MaximilianoMontenegro/TD2/C_FreeRTOS_Digital_ECG_Monitor_DSP/docs/analisis_python/figuras/sesion_ECG_0003.png

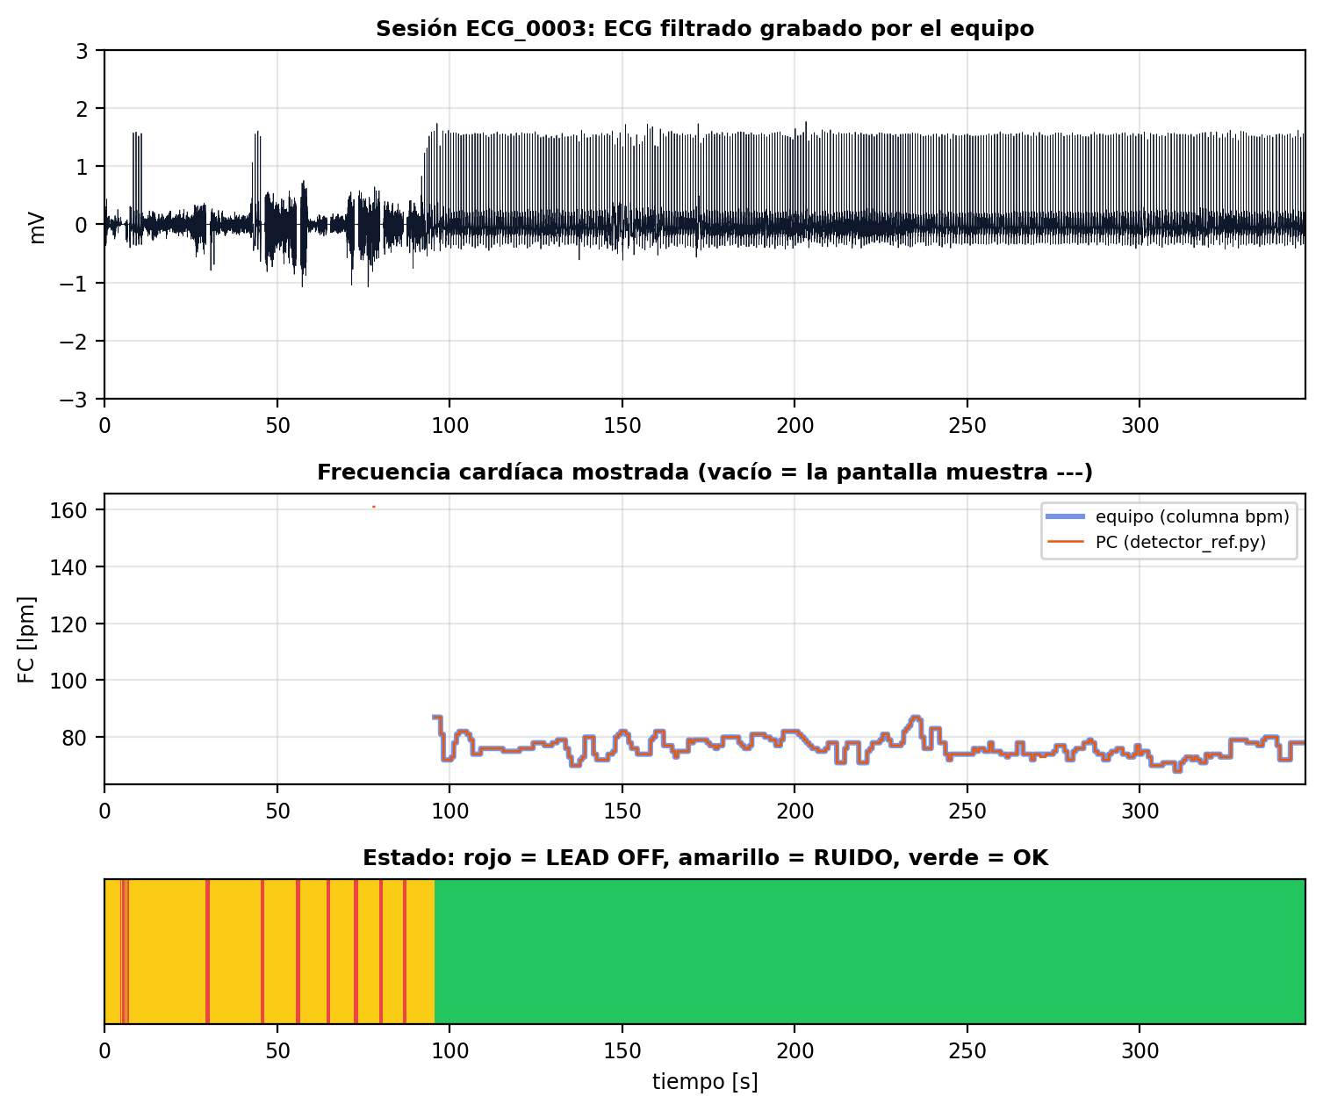
C_FreeRTOS_Digital_ECG_Monitor_DSP/docs/analisis_python/figuras/sesion_ECG_0003.png
