MaximilianoMontenegro/TD2/C_FreeRTOS_Digital_ECG_Monitor_DSP/C_FreeRTOS_Digital_ECG_Monitor_DSP.ioc

Mcu.UserName=STM32F446RETx
PA0-WKUP.GPIO_Label=LCD_RD
PA0-WKUP.Signal=GPIO_Output
PA1.GPIO_Label=LCD_WR
PA1.Signal=GPIO_Output
PA10.GPIO_Label=LCD_D2
PA10.Signal=GPIO_Output
PA13.GPIO_Label=TMS
PA13.Signal=SYS_JTMS-SWDIO
PA14.GPIO_Label=TCK
PA14.Signal=SYS_JTCK-SWCLK
PA2.GPIO_Label=USART_TX
PA2.Signal=USART2_TX
PA3.GPIO_Label=USART_RX
PA3.Signal=USART2_RX
PA4.GPIO_Label=LCD_RS
PA4.Signal=GPIO_Output
PA5.Signal=SPI1_SCK
PA6.Signal=SPI1_MISO
PA7.Signal=SPI1_MOSI
PA8.GPIO_Label=LCD_D7
PA8.Signal=GPIO_Output
PA9.GPIO_Label=LCD_D0
PA9.Signal=GPIO_Output
PB0.GPIO_Label=LCD_CS
PB0.Signal=GPIO_Output
PB10.GPIO_Label=LCD_D6
PB10.Signal=GPIO_Output
PB3.GPIO_Label=LCD_D3
PB3.Signal=GPIO_Output
PB4.GPIO_Label=LCD_D5
PB4.Signal=GPIO_Output
PB5.GPIO_Label=LCD_D4
PB5.Signal=GPIO_Output
PB6.GPIO_Label=SD_CS
PB6.Signal=GPIO_Output
PC0.Signal=ADCx_IN10
PC1.GPIO_Label=LCD_RST
PC1.Signal=GPIO_Output
PC10.GPIO_Label=LO_P
PC10.Signal=GPIO_Input
PC11.GPIO_Label=LO_N
PC11.Signal=GPIO_Input
PC12.GPIO_Label=SDN
PC12.Signal=GPIO_Output
PC13.GPIO_Label=B1 [Blue PushButton]
PC13.Signal=GPXTI13
PC14-OSC32_IN.Signal=RCC_OSC32_IN
PC15-OSC32_OUT.Signal=RCC_OSC32_OUT
PC7.GPIO_Label=LCD_D1
PC7.Signal=GPIO_Output
PH0-OSC_IN.Signal=RCC_OSC_IN
PH1-OSC_OUT.Signal=RCC_OSC_OUT
