MaximilianoMontenegro/TD2/TCII_Filter-NUCLEO_F446RE/app/inc/app.h

/*
===============================================================================
 Name        : app.h
 Author      : Ing. Juan Manuel Cruz, Ing. Cesar Fuoco, Ing. Israel Pavelek
 Version     : 2.0
 Modified    : 9/29/2025
 Copyright   : $(copyright)
 Description : application declaration
===============================================================================
*/

#ifndef INC_APP_H_
#define INC_APP_H_

#include "main.h"
#include "string.h"
#include "filter.h"

void app_init(void);
void app_update(void);

#endif /* INC_APP_H_ */
