MaximilianoMontenegro/TD2/(commit log)

2026-08-24 agrego driver IlI9341 y fuentes
2026-08-24 actualizo el .h y demas archivos
2026-08-28 actualizo driver
2026-08-30 Agrego archivos del driver ILI9341
2026-09-28 Agrego nuevos archivos
    [ECG_LOG.CSV, detector_c_registro.csv, detector_c_sintetico_0.csv, detector_c_sintetico_1.csv, detector_c_sintetico_2.csv, detector_c_sintetico_3.csv, detector_c_sintetico_4.csv, detector_c_sintetico_5.csv]
