MaximilianoMontenegro/TD2/(notices)

Notices in the files:
C_FreeRTOS_Digital_ECG_Monitor_DSP/Core/Src/main.c:
Copyright (c) 2026 STMicroelectronics.
All rights reserved.
This software is licensed under terms that can be found in the LICENSE file
